sunduoze/my_heat/README.md

# my_heat
open source heat

## HW

ESP32-WROOM-32
JW5018B / EUP3458 /JW5026
KLJ-4020
WL2861K33-3-TR
CH224 NC
RT9193
TP6841S6-A
ME3116
MLT-7525
MAX6675ISA
K5-1672SN-01
LM6142
CH340E
SIQ-02FVS3	
OLED-12864-1.3-TOP
KLJ-4020	 buzzer
USB3.1C16PFSMT
XT30PW-M
