sunduoze/my_heat/enzo calc.md

# OpenHeat：开源智能加热台

初始电阻：25摄氏度 R_25 = 2.82 Ohm

软铜电导率 = 0.0175 Ohm*mm^2/m @20℃ 温度系数TCR：0.003951/℃

2.82R @25℃
2.82R*(1 + TCR*(285-25)℃) = 5.71R @285

铝基板热阻 2.0
