sunduoze/my_heat/[HW]my_heat/my_heat bom.xlsx

Bill of Materials Form/零件材料清单表
分发单位 |  |  |  |  |  | 408AL-00043GW
Finished coding/成品编码 |  |  |  |  | Project Name/项目名称 |  |  | Approved By/批准
REV/版本 |  | Description/更改描述 |  |  |  |  |  | Date/日期 |  |  | Raise by/发起人
001
002 |  | Modify U4 to JW5018B |  |  |  |  |  | 2022-04-10
Item/序号 | Level/级别 | Component type/零组件类型 | Model/物料编码=料号 | Name/零件名称 | Description/规格/描述 |  | Manufacturer/ 制造商 | Model/制造商P/N | Qty/用量 | Unit/单位 | Location /元件位置 | Property/环保属性 | Remarks/备注
0 |  |  | Part Number | Category | Description |  | Supplier 1 | Supplier Part Number 1 | Quantity |  | Designator |  |  | Footprint
 | 4 |  | 101CC-00003IA.01 | 贴片电容 | SMD,电容量100nF,额定电压50V,偏差±10%,材质X7R,0603 |  |  | 100nF,0603,50V | 8 |  | C1, C6, C10, C15, C17, C19, C21, C23 |  |  | C0603
 | 4 |  | 101CC-00453BW.01 | 贴片电容 | SMD,电容量10uF,额定电压10V,偏差±10%,材质X7R,0805 |  | YAGEO | CC0805KKX7R6BB106 | 2 |  | C2, C20 |  |  | C0805
 | 4 |  | 101CC-00005IA.01 | 贴片电容 | SMD,电容量1uF,额定电压50V,偏差±10%,材质X5R,0603 |  |  | 1uF,0603,50V | 4 |  | C3, C4, C9, C22 |  |  | C0603
 | 4 |  | 101CC-00006IA.01 | 贴片电容 | SMD,电容量10uF,额定电压25V,偏差±20%,材质X5R,0603 |  |  | 10uF,0603,25V | 2 |  | C5, C8 |  |  | C0603
 | 4 |  | 101CC-00004IA.01 | 贴片电容 | SMD,电容量100pF,额定电压50V,偏差±5%,材质NP0,0603 |  |  | 100pF,0603,50V | 3 |  | C7, C16, C18 |  |  | C0603
 | 4 |  | 101CC-00555BW.01 | 贴片电容 | SMD,电容量10uF,额定电压50V,偏差±10%,材质X7R,1210 |  | YAGEO | CC1210KKX7R9BB106 | 3 |  | C11, C12, C14 |  |  | C1210
 | 4 |  | 101CC-00490BW.01 | 贴片电容 | SMD,电容量220nF,额定电压50V,精度±10%,材质X7R,0603 |  | YAGEO | CC0603KRX7R9BB224 | 1 |  | C13 |  |  | C0603
 | 4 |  | 101CC-00390AV.01 | 贴片电容 | 安装方式SMD,电容量4.7uF,额定电压25V,偏差±10%,材质X5R,0603 |  | Murata | GRM188R61E475KE11D | 3 |  | C24, C25, C26 |  |  | C0603
 | 4 |  | 101RC-00049IA.01 | 贴片电阻 | SMD,阻值470R,精度±1%,0603,额定功率1/10W |  |  | 470R,0603,±1% | 3 |  | R1, R15, R46 |  |  | R0603
 | 4 |  | 101RC-01697BW.01, 101RC-01697BW.01, 101RC-01697BW.01, 101RC-01697BW.01, 101RC-01697BW.01, 101RC-01697BW.01, 101RC-01697BW.01, 101RC-01697BW.01, 101RC-01697BW.01, 101RC-00003IA.01, 101RC-01697BW.01, 101RC-01697BW.01, 101RC-01697BW.01, 101RC-01697BW.01, 101RC-00003IA.01 | 贴片电阻 | SMD,阻值10K,精度±0.1%,0603,额定功率1/10W, SMD,阻值10K,精度±0.1%,0603,额定功率1/10W, SMD,阻值10K,精度±0.1%,0603,额定功率1/10W, SMD,阻值10K,精度±0.1%,0603,额定功率1/10W, SMD,阻值10K,精度±0.1%,0603,额定功率1/10W, SMD,阻值10K,精度±0.1%,0603,额定功率1/10W, SMD,阻值10K,精度±0.1%,0603,额定功率1/10W, SMD,阻值10K,精度±0.1%,0603,额定功率1/10W, SMD,阻值10K,精度±0.1%,0603,额定功率1/10W, SMD,阻值10K,精度±1%,0603,额定功率1/10W, SMD,阻值10K,精度±0.1%,0603,额定功率1/10W, SMD,阻值10K,精度±0.1%,0603,额定功率1/10W, SMD,阻值10K,精度±0.1%,0603,额定功率1/10W, SMD,阻值10K,精度±0.1%,0603,额定功率1/10W, SMD,阻值10K,精度±1%,0603,额定功率1/10W |  | YAGEO, YAGEO, YAGEO, YAGEO, YAGEO, YAGEO, YAGEO, YAGEO, YAGEO, , YAGEO, YAGEO, YAGEO, YAGEO, | RT0603BRD0710KL, RT0603BRD0710KL, RT0603BRD0710KL, RT0603BRD0710KL, RT0603BRD0710KL, RT0603BRD0710KL, RT0603BRD0710KL, RT0603BRD0710KL, RT0603BRD0710KL, 10K,0603,±1%, RT0603BRD0710KL, RT0603BRD0710KL, RT0603BRD0710KL, RT0603BRD0710KL, 10K,0603,±1% | 15 |  | R2, R3, R4, R5, R6, R7, R8, R9, R12, R25, R27, R33, R34, R35, R43 |  |  | R0603
 | 4 |  | 101RC-00016IA.01 | 贴片电阻 | SMD,阻值10R,精度±1%,0603,额定功率1/10W |  |  | 10R,0603,±1% | 5 |  | R10, R14, R18, R23, R29 |  |  | R0603
 | 4 |  | 101RC-01944BW.01 | 贴片电阻 | SMD,阻值30K,精度±1%,0603,额定功率1/10W |  | YAGEO | RC0603FR-0730KL | 2 |  | R11, R22 |  |  | R0603
 | 4 |  | 101RC-00012IA.01 | 贴片电阻 | SMD,阻值0R,精度±1%,0603,额定功率1/10W |  |  | 0R,0603,±1% | 1 |  | R13 |  |  | R0603
 | 4 |  | 101RC-01892BW.01 | 贴片电阻 | SMD,阻值47K,精度±1%,0603,额定功率1/10W |  | YAGEO | RC0603FR-0747KL | 2 |  | R16, R45 |  |  | R0603
 | 4 |  | 101RC-00002IA.01 | 贴片电阻 | SMD,阻值1K,精度±1%,0603,额定功率1/10W |  |  | 1K,0603,±1% | 3 |  | R17, R21, R42 |  |  | R0603
 | 4 |  | 101RC-01223BS.01 | 贴片电阻 | 安装方式SMD,阻值0.01R,精度±1%,2512,额定功率1W,温漂系数±75 ppm/°C |  | Vishay | WSLT2512R0100FEA | 1 |  | R19 |  |  | R2512
 | 4 |  | 101RC-00040IA.01 | 贴片电阻 | SMD,阻值1M,精度±1%,0603,额定功率1/10W |  |  | 1M,0603,±1% | 2 |  | R20, R24 |  |  | R0603
 | 4 |  | 101RC-01784BW.01 | 贴片电阻 | 安装方式SMD,阻值1.5K,精度±1%,0603,额定功率1/10W |  | YAGEO | RC0603FR-071K5L | 1 |  | R26 |  |  | R0603
 | 4 |  | 101RC-00323BW.01 | 贴片电阻 | SMD,阻值100K,精度±0.1%,0603,额定功率1/10W |  | YAGEO | RT0603BRD07100KL | 4 |  | R28, R31, R38, R39 |  |  | R0603
 | 4 |  | 101RC-00378BW.01 | 贴片电阻 | SMD,阻值5.1K,精度±1%,0603,额定功率1/10W |  | YAGEO | RC0603FR-075K1L | 2 |  | R30, R32 |  |  | R0603
 | 4 |  | 101RC-00017IA.01 | 贴片电阻 | SMD,阻值100R,精度±1%,0603,额定功率1/10W |  |  | 100R,0603,±1% | 2 |  | R36, R37 |  |  | R0603
 | 4 |  | 101RC-00027BW.01 | 贴片电阻 | 安装方式SMD,阻值12K,精度±1%,0603,额定功率1/10W |  | YAGEO | RC0603FR-0712KL | 2 |  | R40, R41 |  |  | R0603
 | 4 |  | 101DG-00019AF.01 | 普通二极管 | SMD,SOD-523（0603）,额定电压80V,电流125mA |  | DIODES | 1N4148WT-7 | 1 |  | D1 |  |  | SOD-523
 | 4 |  | 101GP-00002DC.01 | PNP三极管 | SMD,封装形式SOT-23,耐压值40V,额定电流600mA,耗散功率300W |  | 长电科技 | MMBT4403 | 2 |  | Q1, Q2 |  |  | SOT-23-BCE
 | 4 |  | 101GN-00006BA.01 | NPN三极管 | SMD,封装形式SOT-23,耐压值40V,额定电流600mA,耗散功率225mW |  | ON | MMBT2222ALT1G | 4 |  | Q4, Q5, Q6, Q8 |  |  | SOT-23-BCE
 | 4 |  | 101MP-00024BA.01 | P型MOS管 | 安装方式SMD,封装方式SOT-23,额定电压-30V,耗散功率1.0W,Vgs-2.6V,额定电流-2.5A |  | ON | CPH3355-TL-W | 1 |  | Q7 |  |  | SOT-23-GDS
 | 4 |  | R0603 | 贴片电阻 | SMD，910K |  |  | 910k | 1 |  | R44 | D类 |  | R0603
 | 4 |  | MAX6675ISA+ |  | IC THERMOCOUP TO DGTL 8-SOIC |  | Digi-Key | MAX6675ISA+-ND (https://octopart-clicks.com/click/altium?sku=700-MAX6675ISA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) | 1 |  | U2 | D类 | V | SOIC8-1R27-5X4
 | 4 |  | 101IF-00039BK.01 | 运放IC | 安装方式SMD,SOIC-8,8PIN,运算放大器, |  | TI | LM6142 | 1 |  | U3 | D类 | M | SOIC8-1R27-5X4
 | 4 |  |  |  |  |  | JW | JW5018B | 1 |  | U4 | D类 | V | SOT-23-6_L2.9-W1.6-P0.95-LS2.8-BR
 | 4 |  |  |  |  |  | WILLSEMI(Will Semicon) | WL2861K33-3/TR | 1 |  | U5 | D类 | V | SOT-89-3_L4.5-W2.5-P1.50-LS4.2-BR
 | 4 |  |  |  |  |  |  | CH340E | 1 |  | U6 | D类 | V | MSOP-10_L3.0-W3.0-P0.50-LS5.0-BL
 | 4 |  |  |  | USB PD & Type-C & Fast Charge Power Consumer Controller |  |  | CH224K | 1 |  | U7 | D类 | V | ESSOP10
 | 4 |  |  |  |  |  | 精拓金 (https://list.szlcsc.com/brand/11735.html) | 918-418K2023S40001 | 1 |  | USB1 | D类 | V | Type-C-TOP
 | 4 |  |  | 拨轮滚轮旋转编码器开关 | SIQ-02FVS3 |  | MITSUMI(美上美) (https://list.szlcsc.com/brand/259.html) | 'SIQ-02FVS3 | 1 |  | SW1 | D类 | V
 | 4 |  |  |  |  |  |  | XT30PW-M | 1 |  | CN1 | D类 | NC | CONN-TH_XT30PW-M
 | 4 |  |  |  |  |  |  | SMBJ33CA | 1 |  | D2 | D类 | V | SMBJ-CA_MFG
 | 4 |  |  |  |  |  | KELIKING | KLJ-4020 | 1 |  | BUZZER1 | D类 | V | BUZ-SMD_L4.0-W4.0-P3.50-L
 | 4 |  |  |  |  |  |  | ESP32-WROOM-32 | 1 |  | U1 | D类 | M | WIFIM-SMD_ESP-32S
 | 4 |  | 101MN-00036AM.01 | N型MOS管 | SMD,封装方式TO263-3, |  | TI | CSD | 1 |  | Q3 | D类 | M | D2PAK-3-GDS
 | 4 |  |  |  |  |  | kinghelm(金航标) | KH-DC-007B-2.5G | 1 |  | DC1 | D类 | V
 | 4 |  |  |  |  |  |  | K5-1672SN-01 | 1 |  | SW2 | D类 | V
 | 4 |  |  |  | 显示屏 |  |  |  | 1 |  | OLED | D类 | NC | OLED-12864-1.3-TOP
 | 4 |  |  |  |  |  |  |  | 1 |  | OLED1 | D类 | M | OLED_0.69_8Pin
 | 4 |  | 101LP-00508BV.01 | 功率电感 | 安装方式SMD,电感值10uH,精度±20%,额定电流1.5A,屏蔽式,4.45x4.06x1.8mm |  | Wurth | 74437324100 SLO0420H100MTT | 1 |  | L1 | D类 | V | IND4R45X4R06X1-2 | Sunltech(韩国顺磁) (https://list.szlcsc.com/brand/11440.html)
 | 4 |  | 101DS-00045AF.01 | 肖特基二极管 | SMD,封装外壳SMC（DO-214AB）,额定电压40V,电流5A |  | DIODES | B540C-13-F | 1 |  | D5 | D类 | V | SMC
 | 4 |  | 101DS-00017AI.01 | 肖特基二极管 | SMD,封装外壳SOD-123-2,额定电压40V,电流1A |  | Fairchild | SS14FL | 2 |  | D3, D4 | D类 | V | SOD-123FL
