sunduoze/my_heat/[FW]my_heat/调试/esp32 adc.png

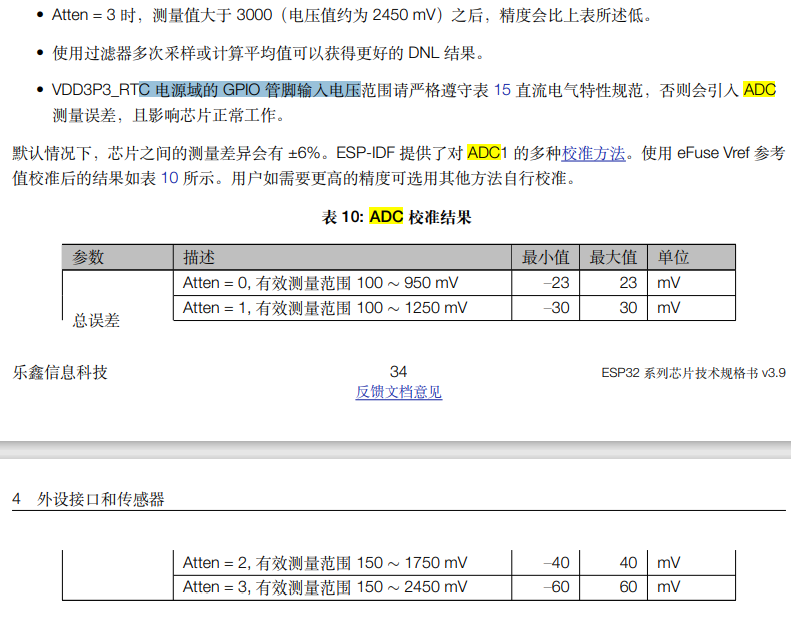
[FW]my_heat/调试/esp32 adc.png
