sunduoze/my_heat/[FW]my_heat/调试/kp8000-2.png

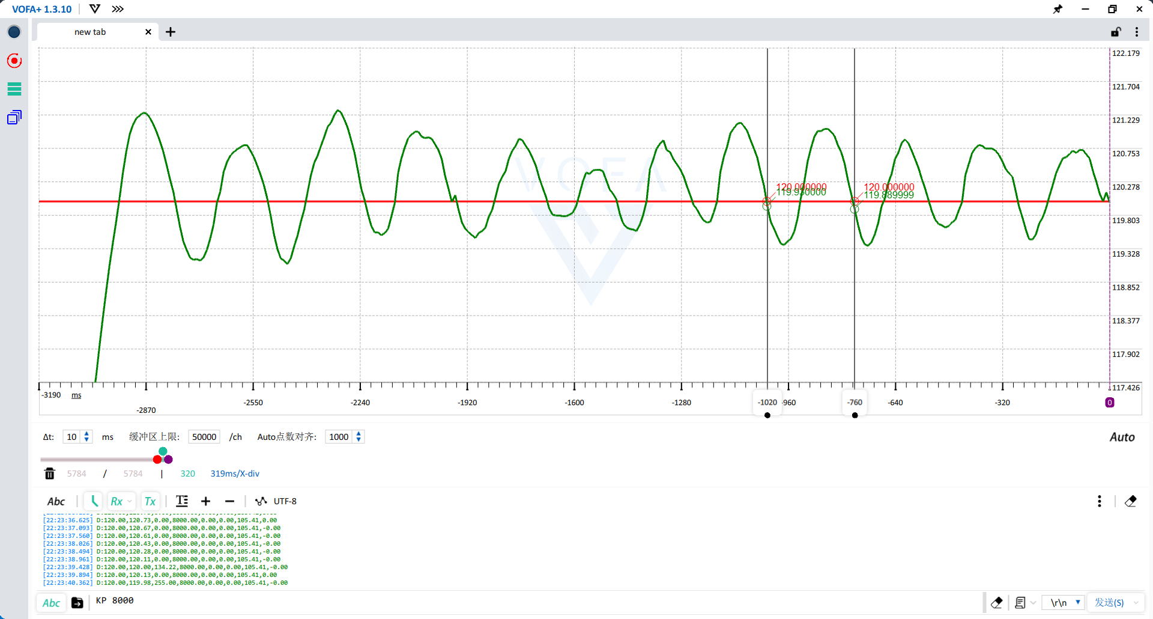
[FW]my_heat/调试/kp8000-2.png
