sunduoze/my_heat/[FW]my_heat/调试/Snipaste_2022-04-10_23-42-30.png

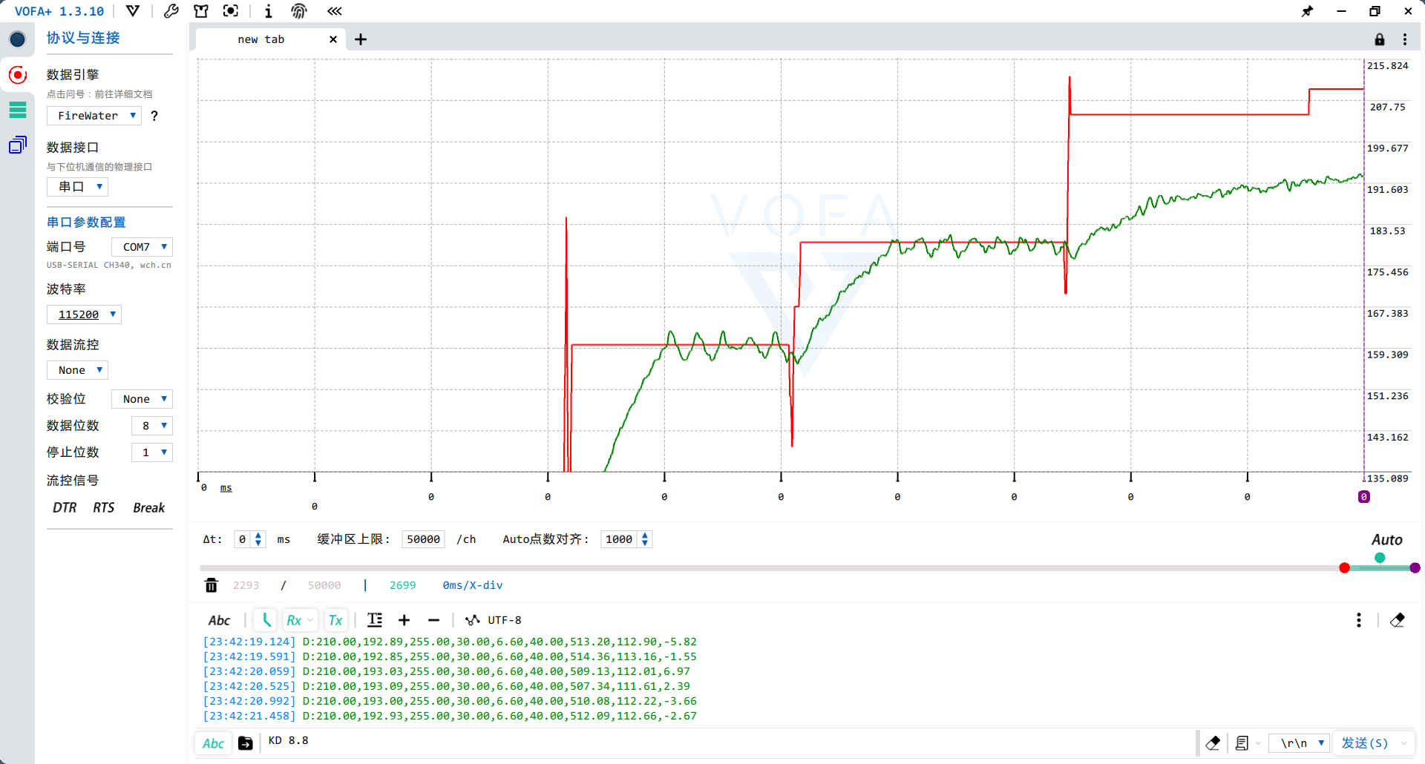
[FW]my_heat/调试/Snipaste_2022-04-10_23-42-30.png
