sunduoze/my_heat/(threads)

Thread 1 (2022-03-27):

错料

sunduoze, 2022-03-27:
1. DC1 下错料：KH-DC-007B-2.1G 应该修改为：KH-DC-007B-2.5G
2. TYPEC 错料：                               应该为：USB3.1C16PFSMT

sunduoze, 2022-03-27:
2.TYPEC 错料： 应该为：[精拓金](https://list.szlcsc.com/brand/11735.html) 918-418K2023S40001

sunduoze, 2022-03-27:
commit@20220327  fix this issue.

Closed 2022-03-27.

Thread 2 (2022-03-31):

npn & pnp 等相关电路设计错误

sunduoze, 2022-03-31:
pull-push circuit error
buzzer & pmos driver(need use npn).

sunduoze, 2022-03-31:
commit@20220331 fix pull-push circuit error, fix buzzer & pmos driver(need use npn).

Closed 2022-03-31.

Thread 3 (2022-04-01):

CH340E & CH224K USB存在抢占问题，导致CH340E无法使用

sunduoze, 2022-04-01:
CH340E & CH224K USB DP DN 均并联，导致存在抢占问题（USB PD正常，USB转串口无法使用）

sunduoze, 2022-04-01:
手动测量usb A口转C口 cable中A面DP DN 与B面DP DN不相连，拟采取插A面为USB转串口，插B面为PD受电端

Thread 4 (2022-04-07):

mosfet driver design failure

sunduoze, 2022-04-07:
first version----应该为上NPN，下PNP
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

sunduoze, 2022-04-07:
推挽电路输出电平电压会低于输入电平电压
![before](
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
https://user-images.githubusercontent.com/10105111/162122557-99a85a97-5852-46a7-8830-76632cdc7274.png)

sunduoze, 2022-04-07:
临时整改措施：
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
[mos-driver  push-pull circuit.zip](https://github.com/sunduoze/my_heat/files/8439746/mos-driver.push-pull.circuit.zip)

sunduoze, 2022-04-07:
临时整改措施：
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
仿真文件：
[mos-driver  push-pull circuit.zip](https://github.com/sunduoze/my_heat/files/8439746/mos-driver.push-pull.circuit.zip)

sunduoze, 2022-04-07:
commit@20220406 fix this issue
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

Closed 2022-04-07.
