sunduoze/my_heat/[HW]my_heat/my_heat.pdf

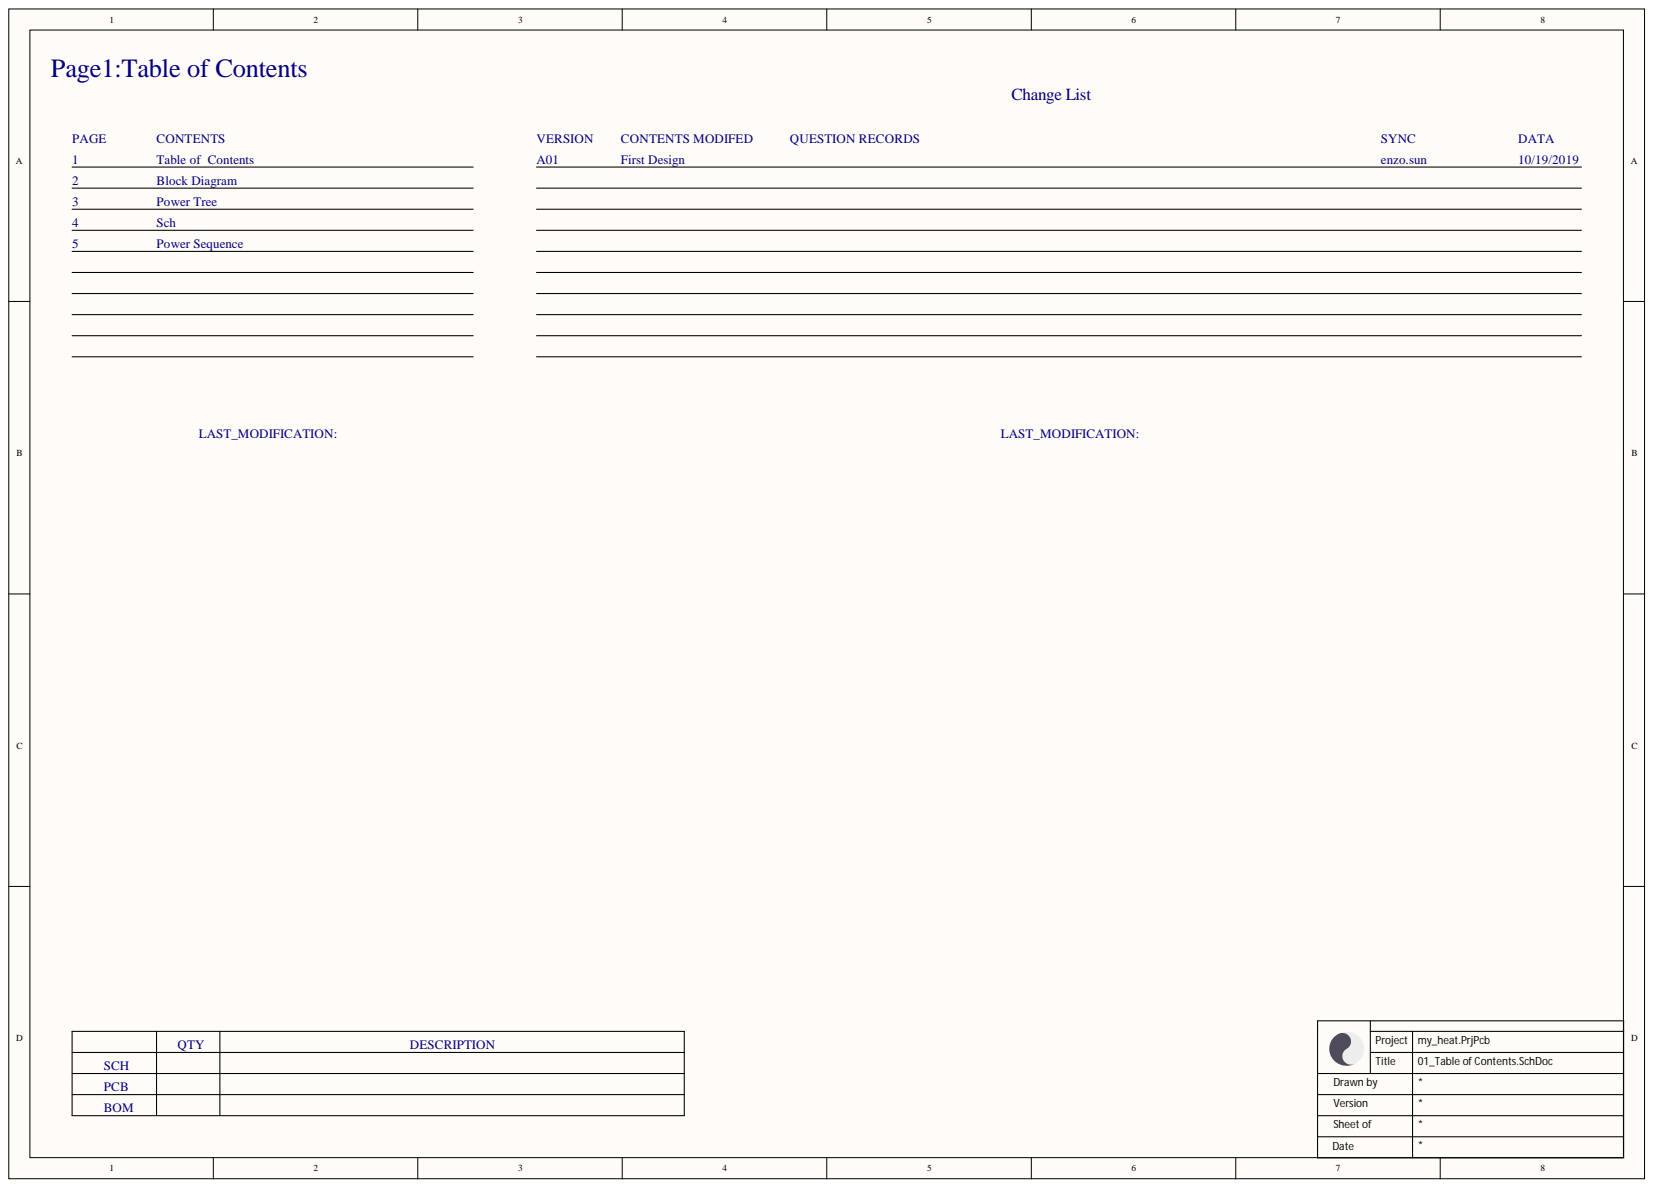
[picture p5: page 1]

Sheet of

Date | *

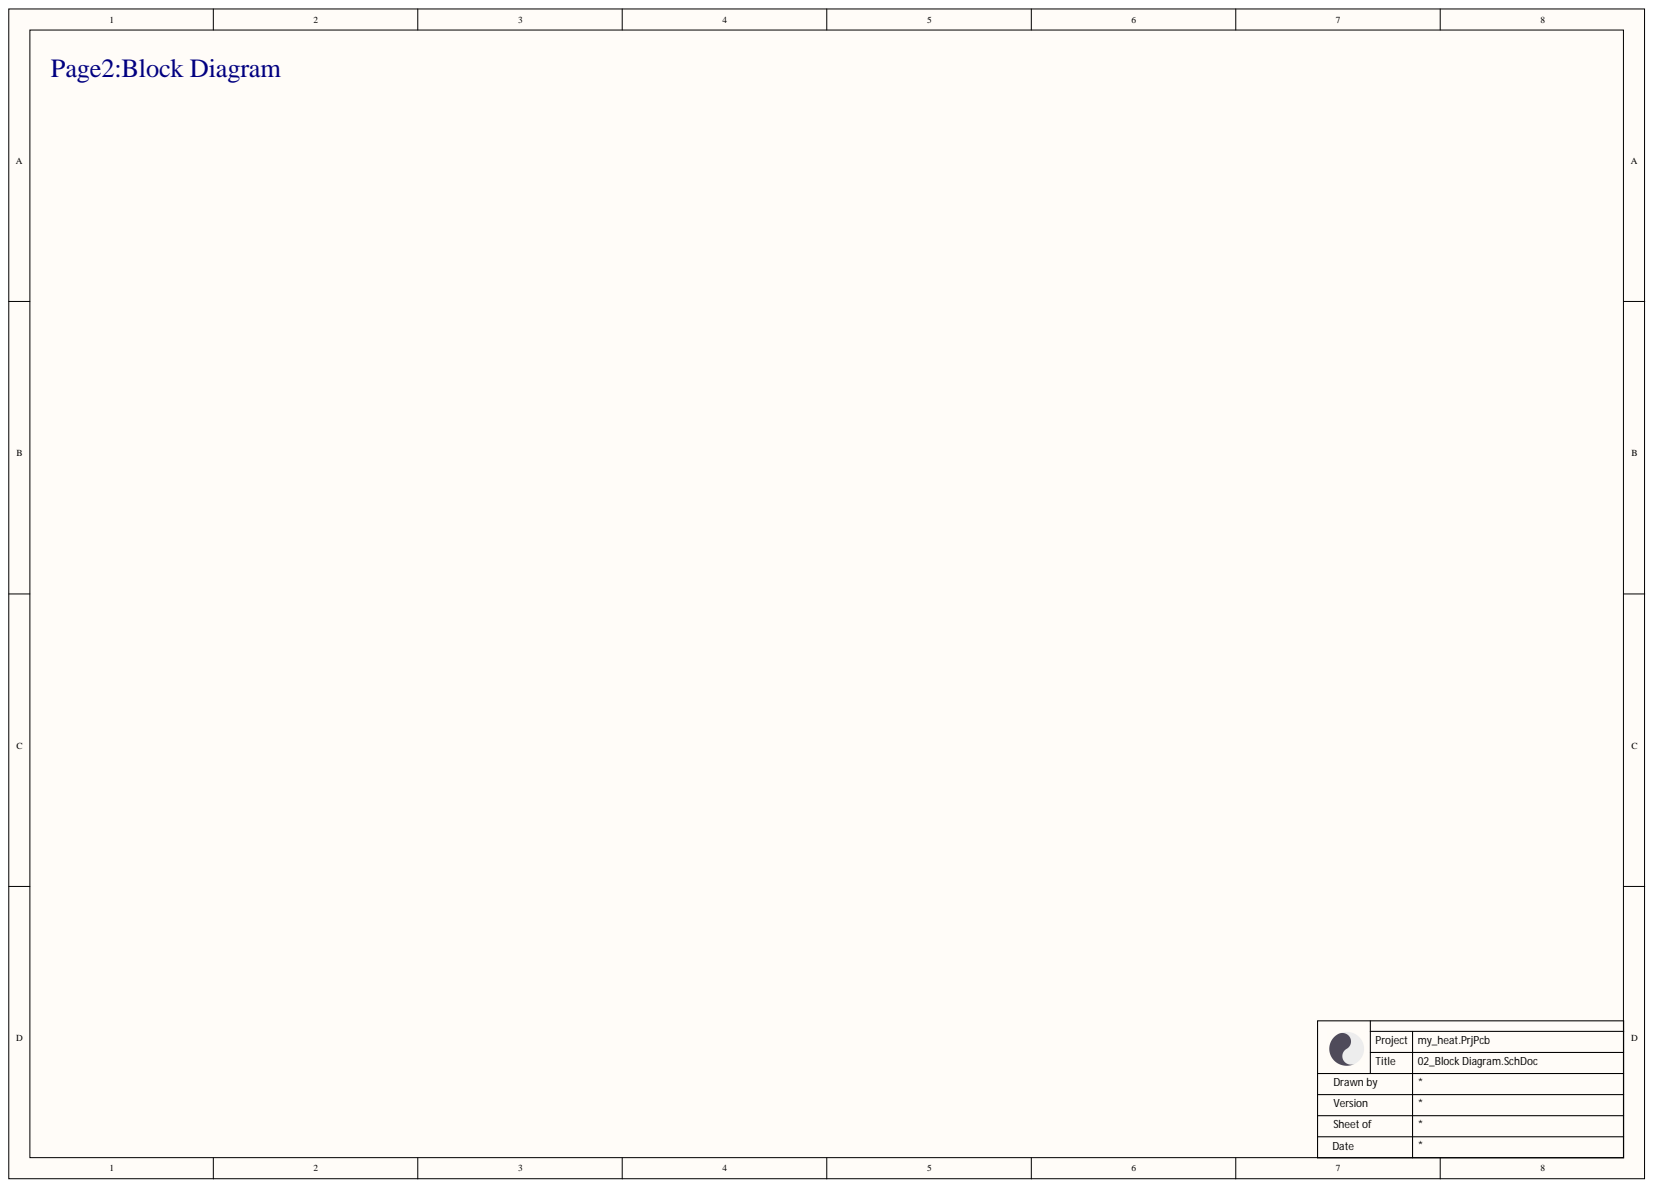
[picture p6: page 2]

Project | my_heat.PrjPcb

Title | 02_Block Diagram.SchDoc

Drawn by | | *

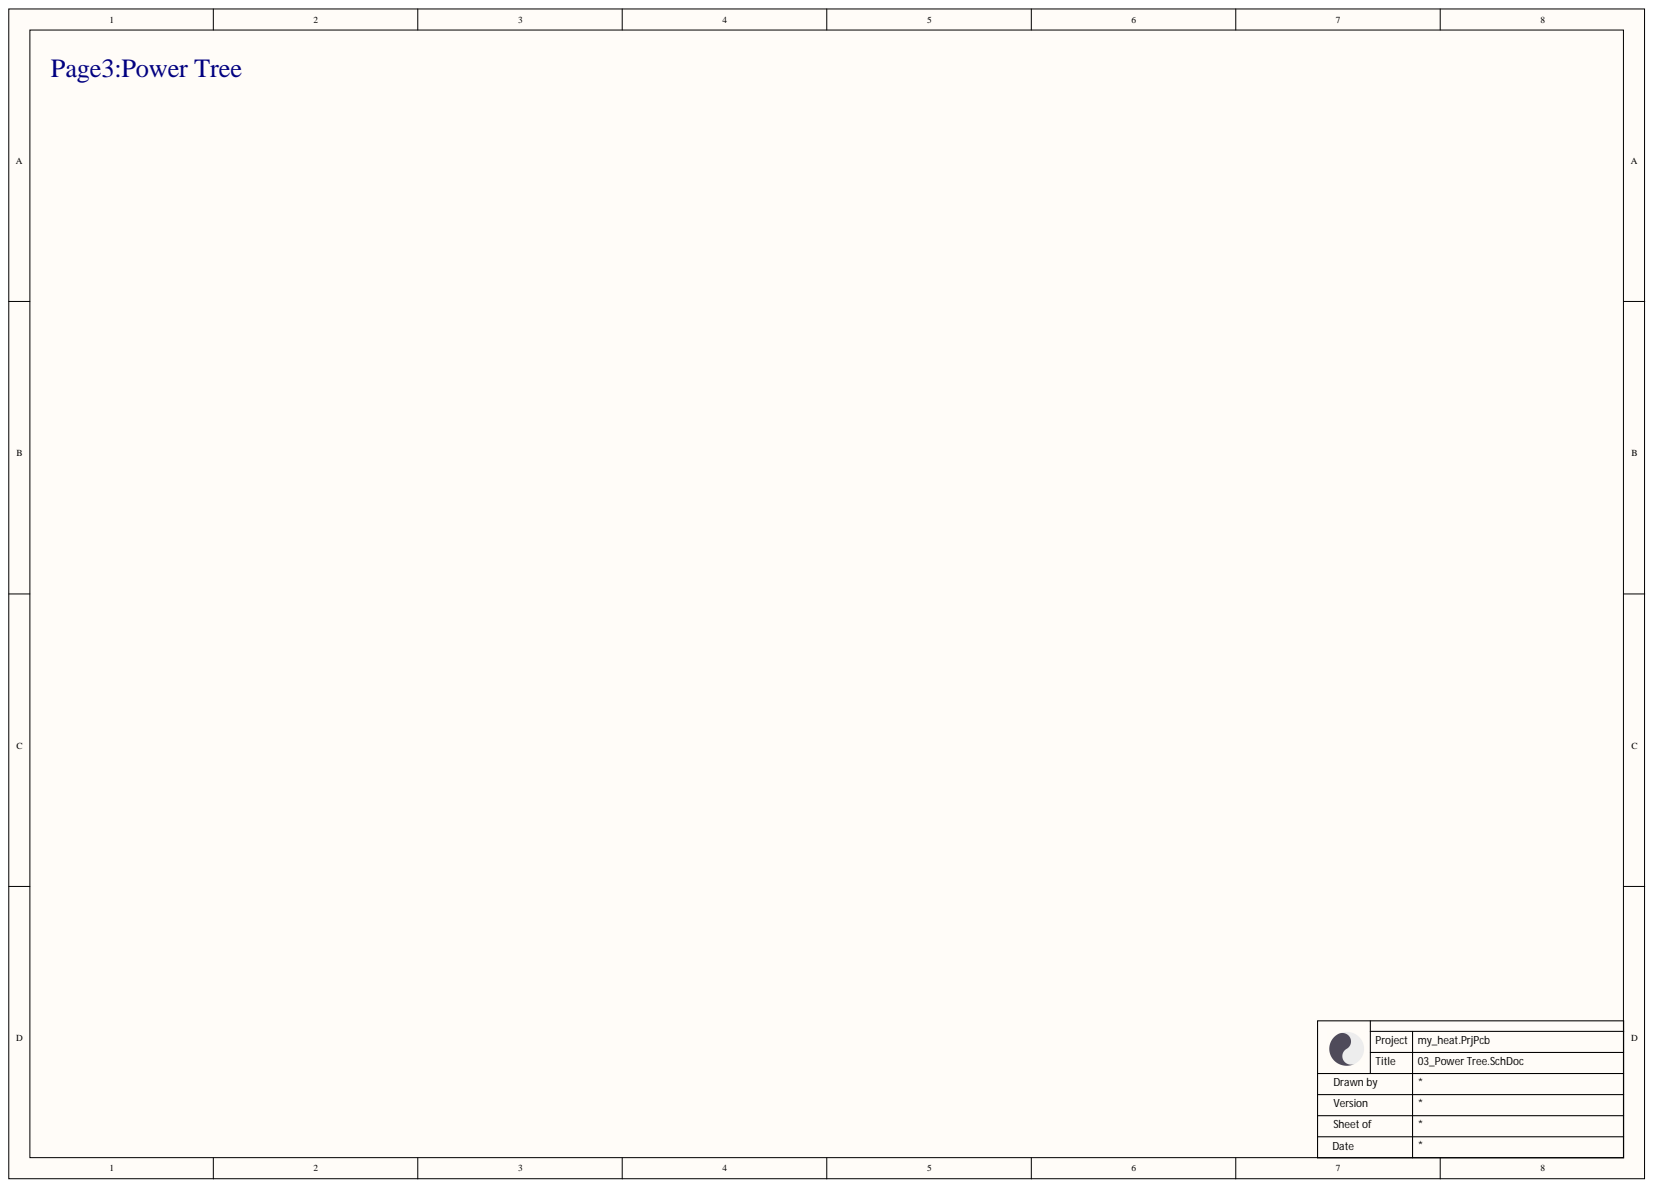
[picture p7: page 3]

Project | my_heat.PrjPcb

Title | 03_Power Tree.SchDoc

Drawn by | | *

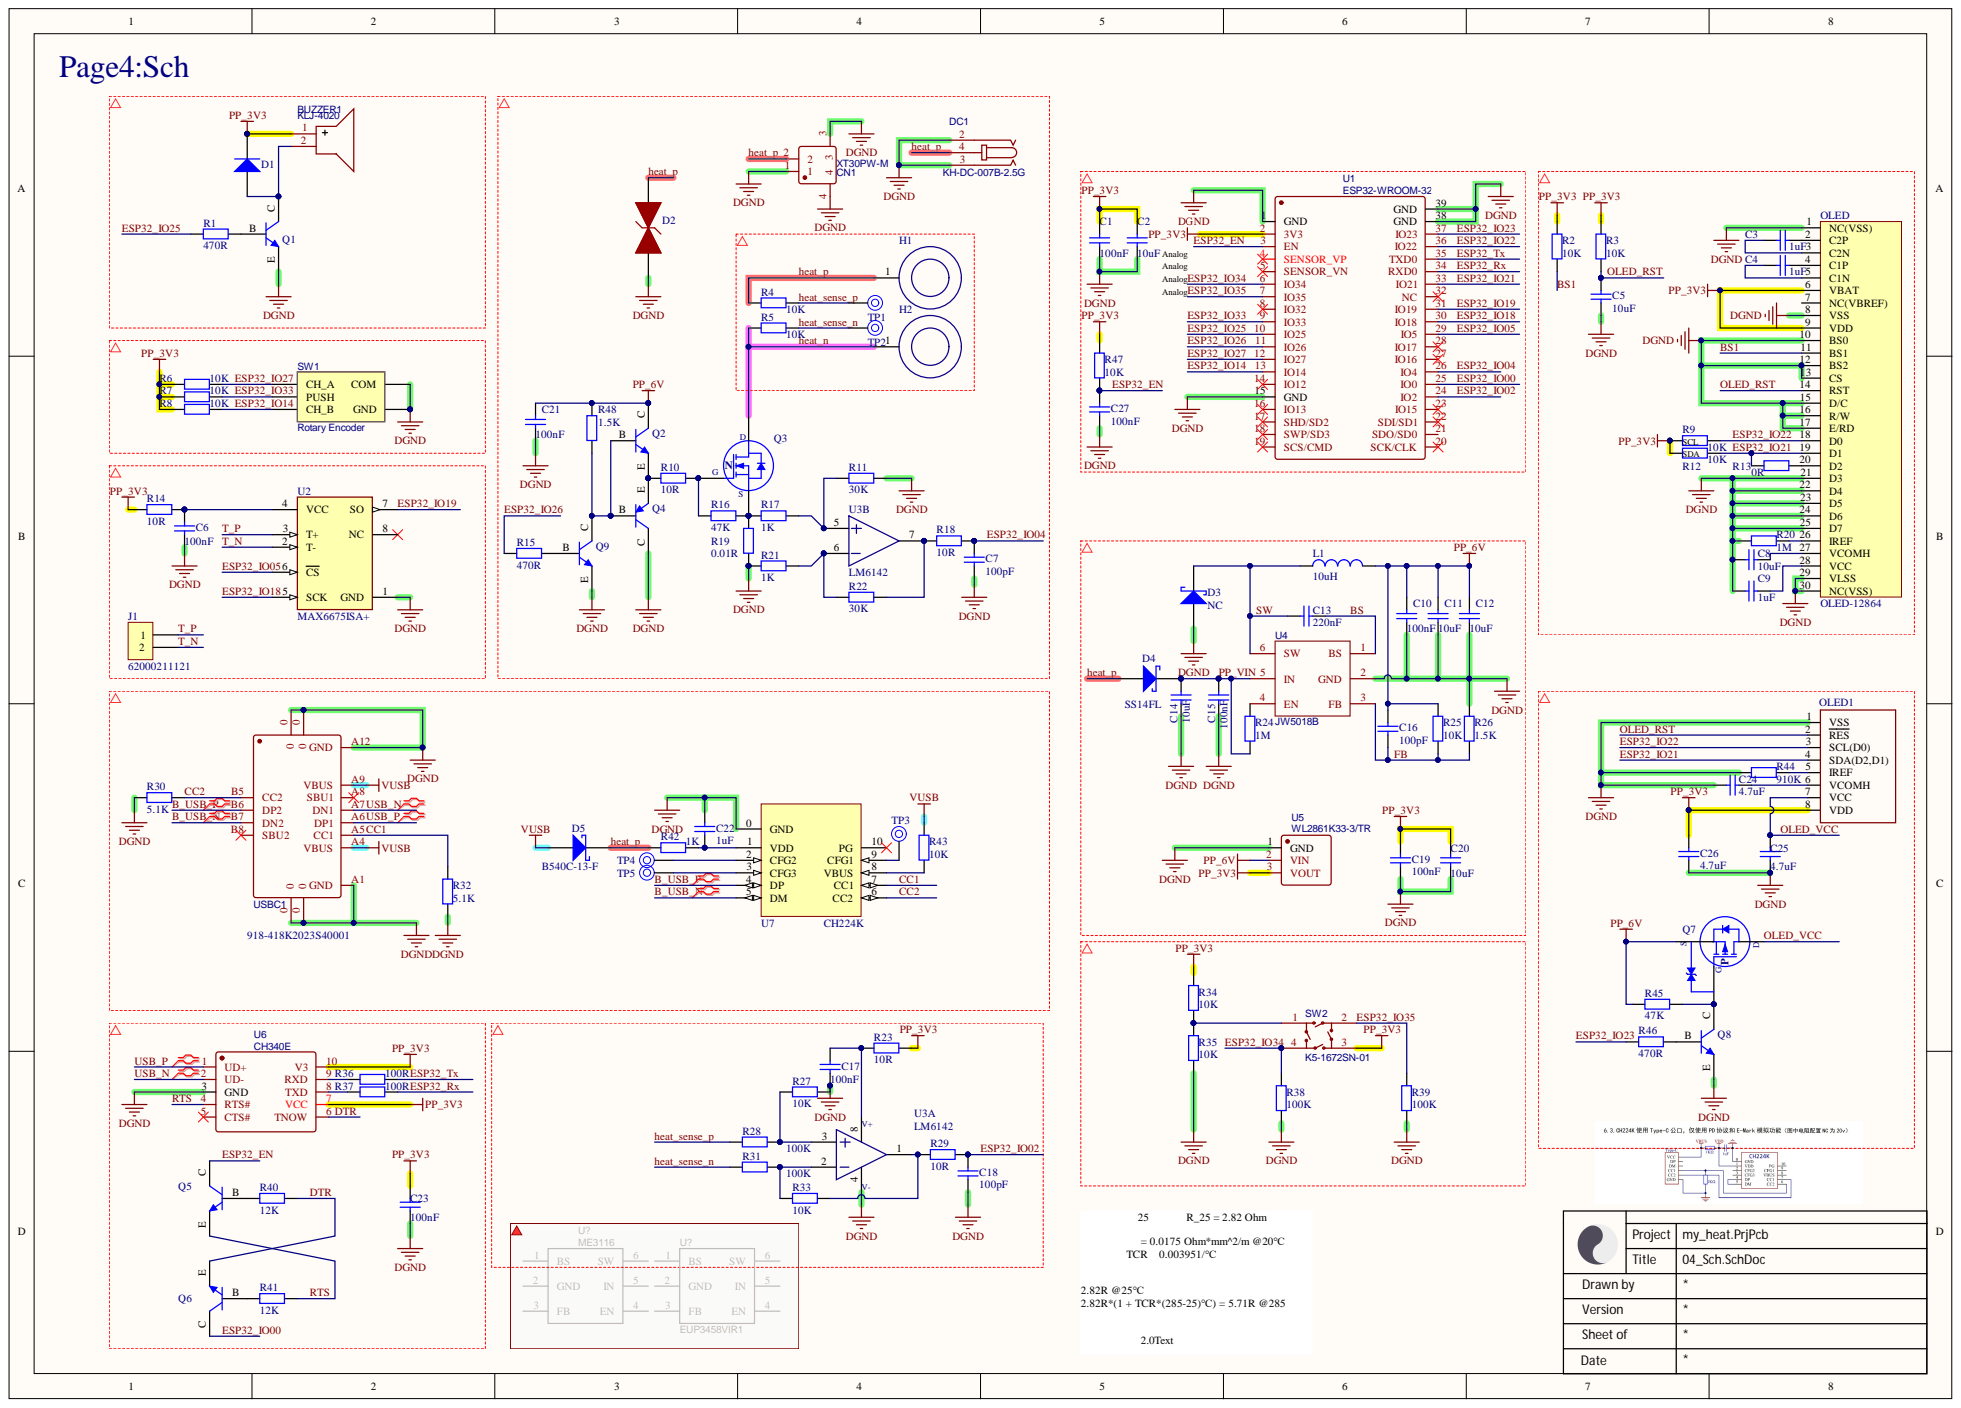
[picture p8: page 4]

PP_3V3 | | VCC 7

Title | 04_Sch.SchDoc

Drawn by | *

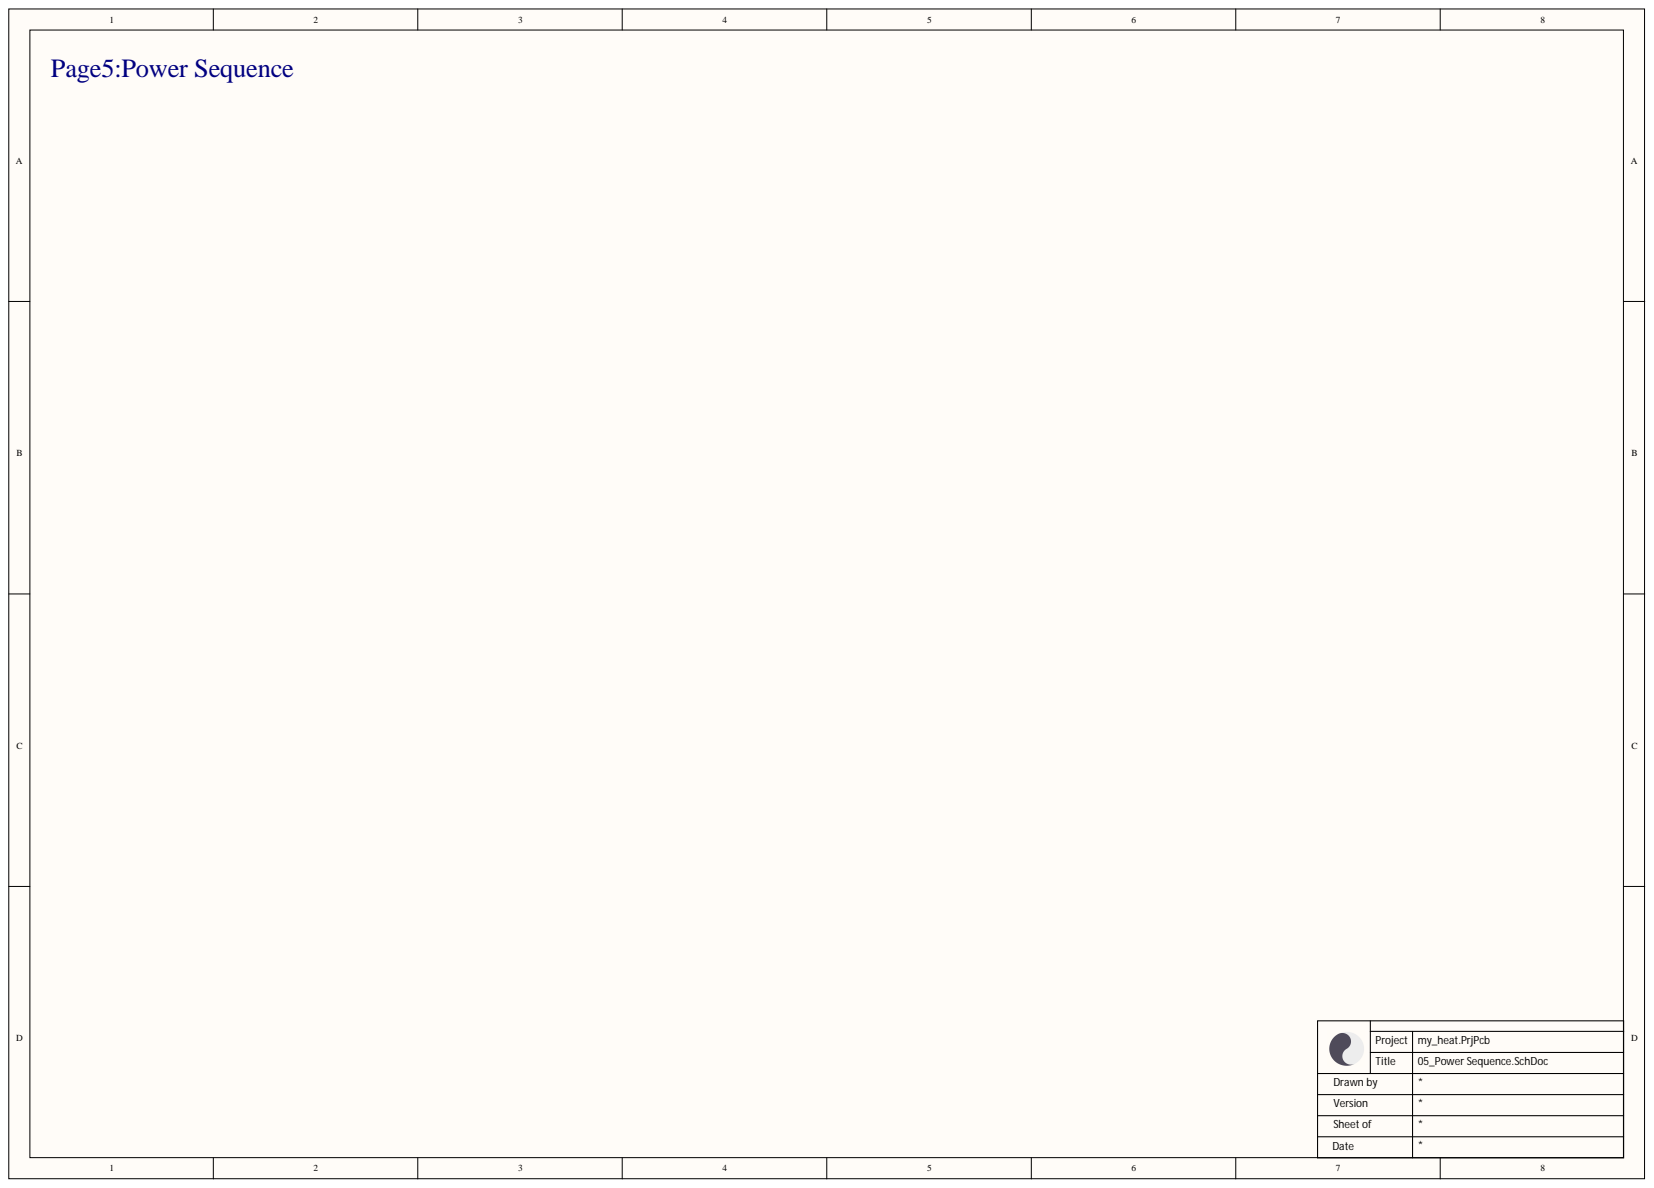
[picture p9: page 5]

Project | my_heat.PrjPcb

Title | 05_Power Sequence.SchDoc

Drawn by | | *

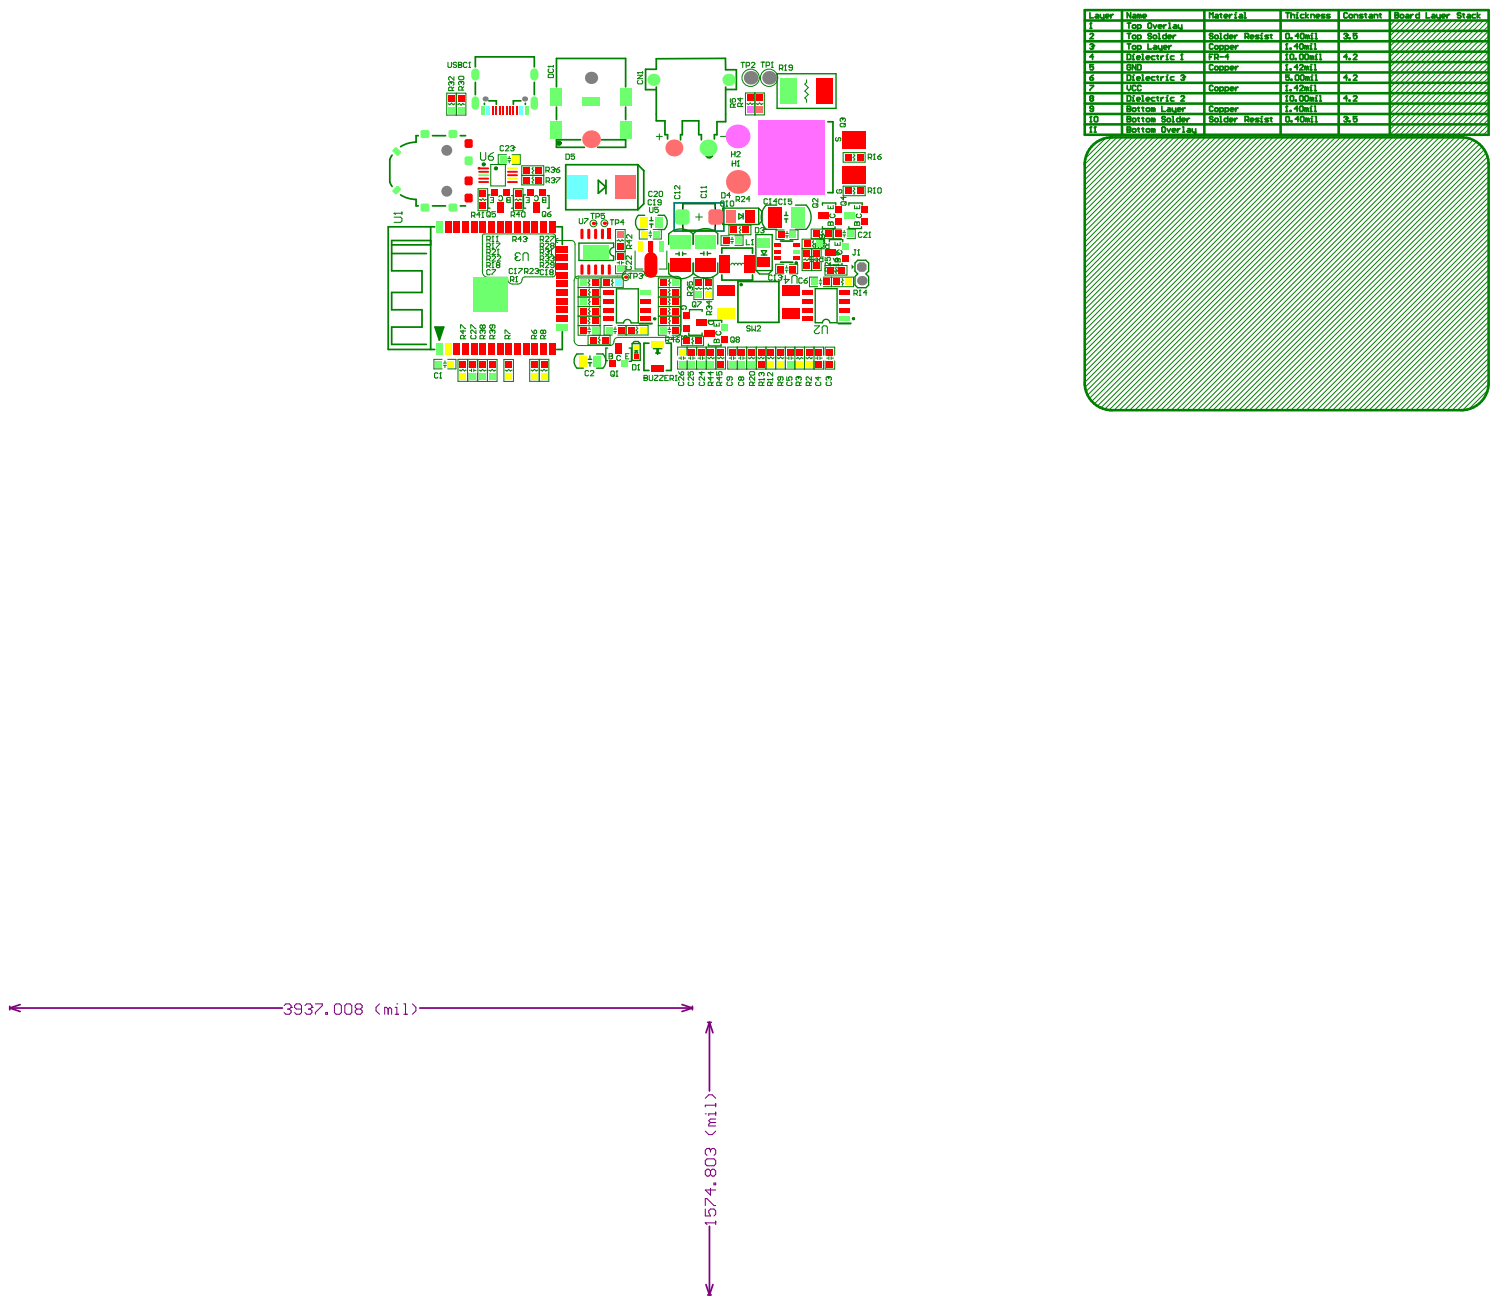
[picture p10: page 6]

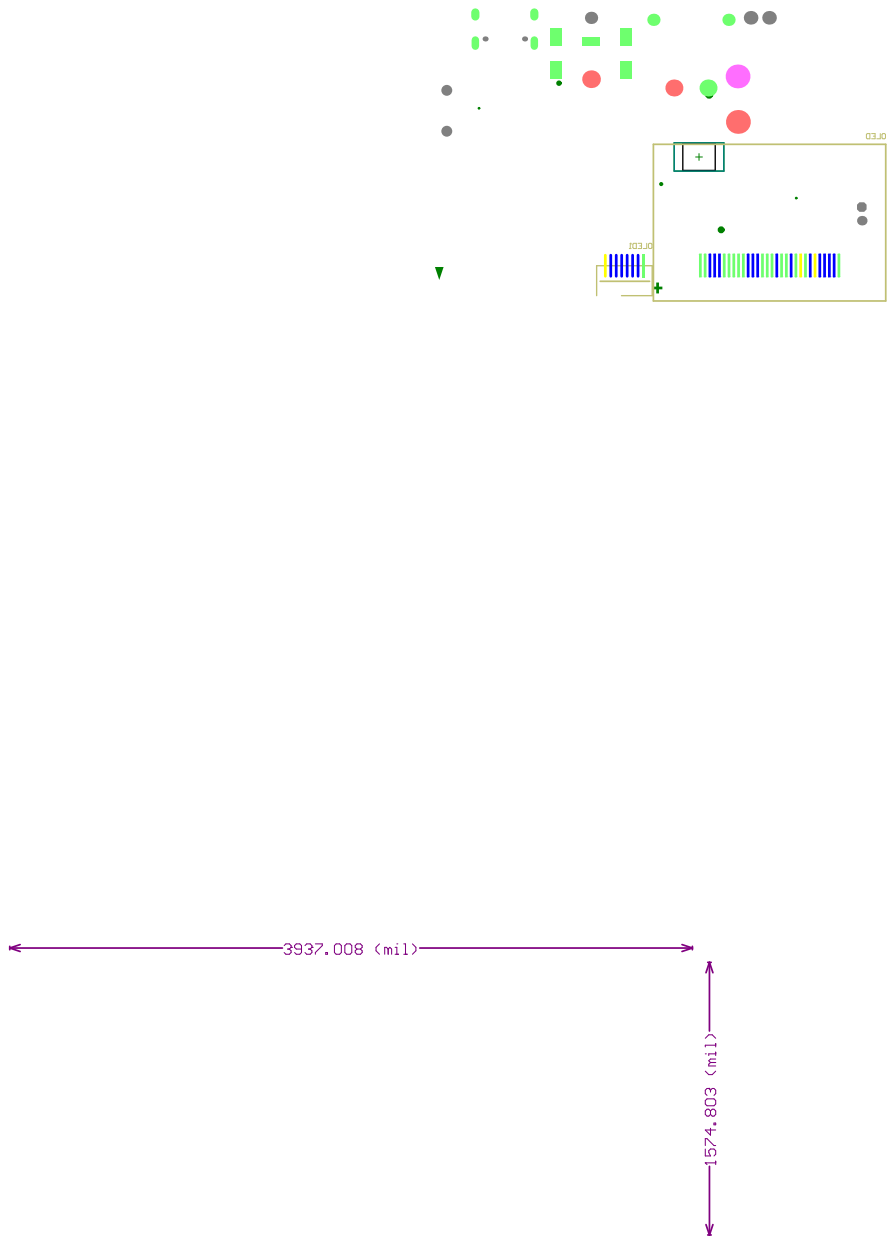
[picture p11: page 7]

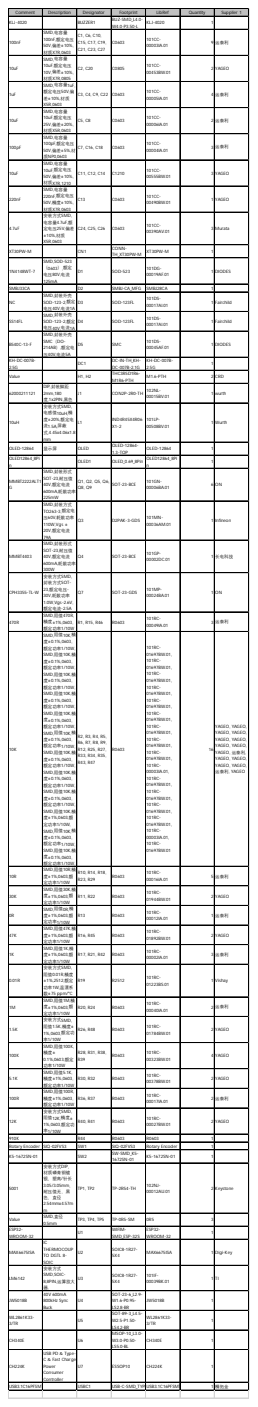
[picture p12: page 8]

Comment | Description | Designator | Footprint | LibRef | Quantity | Supplier 1
KLJ-4020 | | BUZZER1 | BUZ-SMD_L4.0-W4.0-P3.50-L | KLJ-4020 | | 1

100nF | SMD,电容量 100nF,额定电压 50V,偏差±10%, 材质X7R,0603 | C1, C6, C10, C15, C17, C19, C21, C23, C27 | C0603 | 101CC-00003IA.01 | | 9 运泰利

10uF | SMD,电容量 10uF,额定电压 10V,偏差±10%, 材质X7R,0805 | C2, C20 | C0805 | 101CC-00453BW.01 | | 2 YAGEO

1uF | SMD,电容量1uF, 额定电压50V,偏 差±10%,材质 X5R,0603 | C3, C4, C9, C22 | C0603 | 101CC-00005IA.01 | | 4 运泰利

10uF | SMD,电容量 10uF,额定电压 25V,偏差±20%, 材质X5R,0603 | C5, C8 | C0603 | 101CC-00006IA.01 | | 2 运泰利

100pF | SMD,电容量 100pF,额定电压 50V,偏差±5%,材 质NP0,0603 | C7, C16, C18 | C0603 | 101CC-00004IA.01 | | 3 运泰利

10uF | SMD,电容量 10uF,额定电压 50V,偏差±10%, 材质X7R,1210 | C11, C12, C14 | C1210 | 101CC-00555BW.01 | | 3 YAGEO

220nF | SMD,电容量 220nF,额定电压 50V,精度±10%, 材质X7R,0603 | C13 | C0603 | 101CC-00490BW.01 | | 1 YAGEO

4.7uF | 安装方式SMD, 电容量4.7uF,额 定电压25V,偏差 ±10%,材质 X5R,0603 | C24, C25, C26 | C0603 | 101CC-00390AV.01 | | 3 Murata

XT30PW-M | | CN1 | CONN-TH_XT30PW-M | XT30PW-M | | 1

1N4148WT-7 | SMD,SOD-523 （0603）,额定 电压80V,电流 125mA | D1 | SOD-523 | 101DG-00019AF.01 | | 1 DIODES

SMBJ33CA | | D2 | SMBJ-CA_MFG | SMBJ28CA | | 1
NC | SMD,封装外壳 SOD-123-2,额定 电压40V,电流1A | D3 | SOD-123FL | 101DS-00017AI.01 | | 1 Fairchild

SS14FL | SMD,封装外壳 SOD-123-2,额定 电压40V,电流1A | D4 | SOD-123FL | 101DS-00017AI.01 | | 1 Fairchild

B540C-13-F | SMD,封装外壳 SMC（DO-214AB）,额定电 压40V,电流5A | D5 | SMC | 101DS-00045AF.01 | | 1 DIODES

Value | | H1, H2 | THC3R5D1R6-M1R6-PTH | M1.6-PTH | | 2 CRD

62000211121 | DIP,封装脚距 2mm,180 度,1x2PIN,黑色 | J1 | CON2P-2R0-TH | 102NL-00015BV.01 | | 1 wurth

10uH | 安装方式SMD, 电感值10uH,精 度±20%,额定电 流1.5A,屏蔽 式,4.45x4.06x1.8 mm | L1 | IND4R45X4R06 X1-2 | 101LP-00508BV.01 | | 1 Wurth

OLED-12864 | 显示屏 | OLED | OLED-12864-1.3-TOP | OLED-12864 | | 1

OLED12864_8Pi n | | OLED1 | OLED_0.69_8Pin | OLED12864_8Pi n | | 1

MMBT2222ALT1 G | SMD,封装形式 SOT-23,耐压值 40V,额定电流 600mA,耗散功率 225mW | Q1, Q2, Q5, Q6, Q8, Q9 | SOT-23-BCE | 101GN-00006BA.01 | | 6 ON

SMD,封装方式 TO263-3,额定电 压60V,耗散功率 110W,Vgs ± 20V,额定电流 79A | Q3 | D2PAK-3-GDS | 101MN-00036AM.01 | | 1 Infineon

MMBT4403 | SMD,封装形式 SOT-23,耐压值 40V,额定电流 600mA,耗散功率 300W | Q4 | SOT-23-BCE | 101GP-00002DC.01 | | 1 长电科技

CPH3355-TL-W | 安装方式SMD, 封装方式SOT-23,额定电压-30V,耗散功率 1.0W,Vgs-2.6V, 额定电流-2.5A | Q7 | SOT-23-GDS | 101MP-00024BA.01 | | 1 ON

470R | SMD,阻值470R, 精度±1%,0603, 额定功率1/10W | R1, R15, R46 | R0603 | 101RC-00049IA.01 | | 3 运泰利

10K | SMD,阻值10K,精 度±0.1%,0603, 额定功率1/10W, SMD,阻值10K,精 度±0.1%,0603, 额定功率1/10W, SMD,阻值10K,精 度±0.1%,0603, 额定功率1/10W, SMD,阻值10K,精 度±0.1%,0603, 额定功率1/10W, SMD,阻值10K,精 度±0.1%,0603, 额定功率1/10W, SMD,阻值10K,精 度±0.1%,0603, 额定功率1/10W, SMD,阻值10K,精 度±0.1%,0603, 额定功率1/10W, SMD,阻值10K,精 度±0.1%,0603, 额定功率1/10W, SMD,阻值10K,精 度±0.1%,0603, 额定功率1/10W, SMD,阻值10K,精 度±1%,0603,额 定功率1/10W, SMD,阻值10K,精 度±0.1%,0603, 额定功率1/10W, SMD,阻值10K,精 度±0.1%,0603, 额定功率1/10W, | R2, R3, R4, R5, R6, R7, R8, R9, R12, R25, R27, R33, R34, R35, R43, R47 | R0603 | 101RC-01697BW.01, 101RC-01697BW.01, 101RC-01697BW.01, 101RC-01697BW.01, 101RC-01697BW.01, 101RC-01697BW.01, 101RC-01697BW.01, 101RC-01697BW.01, 101RC-01697BW.01, 101RC-00003IA.01, 101RC-01697BW.01, 101RC-01697BW.01, 101RC-01697BW.01, 101RC-01697BW.01, 101RC-00003IA.01, 101RC-01697BW.01 | | YAGEO, YAGEO, YAGEO, YAGEO, YAGEO, YAGEO, 16 YAGEO, YAGEO, YAGEO, 运泰利, YAGEO, YAGEO, YAGEO, YAGEO, 运泰利, YAGEO

10R | SMD,阻值10R,精 度±1%,0603,额 定功率1/10W | R10, R14, R18, R23, R29 | R0603 | 101RC-00016IA.01 | | 5 运泰利

30K | SMD,阻值30K,精 度±1%,0603,额 定功率1/10W | R11, R22 | R0603 | 101RC-01944BW.01 | | 2 YAGEO

0R | SMD,阻值0R,精 度±1%,0603,额 定功率1/10W | R13 | R0603 | 101RC-00012IA.01 | | 1 运泰利

47K | SMD,阻值47K,精 度±1%,0603,额 定功率1/10W | R16, R45 | R0603 | 101RC-01892BW.01 | | 2 YAGEO

1K | SMD,阻值1K,精 度±1%,0603,额 定功率1/10W | R17, R21, R42 | R0603 | 101RC-00002IA.01 | | 3 运泰利

0.01R | 安装方式SMD, 阻值0.01R,精度 ±1%,2512,额定 功率1W,温漂系 数±75 ppm/°C | R19 | R2512 | 101RC-01223BS.01 | | 1 Vishay

1M | SMD,阻值1M,精 度±1%,0603,额 定功率1/10W | R20, R24 | R0603 | 101RC-00040IA.01 | | 2 运泰利

1.5K | 安装方式SMD, 阻值1.5K,精度± 1%,0603,额定功 率1/10W | R26, R48 | R0603 | 101RC-01784BW.01 | | 2 YAGEO

100K | SMD,阻值100K, 精度± 0.1%,0603,额定 功率1/10W | R28, R31, R38, R39 | R0603 | 101RC-00323BW.01 | | 4 YAGEO

5.1K | SMD,阻值5.1K, 精度±1%,0603, 额定功率1/10W | R30, R32 | R0603 | 101RC-00378BW.01 | | 2 YAGEO

100R | SMD,阻值100R, 精度±1%,0603, 额定功率1/10W | R36, R37 | R0603 | 101RC-00017IA.01 | | 2 运泰利

12K | 安装方式SMD, 阻值12K,精度± 1%,0603,额定功 率1/10W | R40, R41 | R0603 | 101RC-00027BW.01 | | 2 YAGEO

910K | | R44 | R0603 | R0603 | | 1
Rotary Encoder | SIQ-02FVS3 | SW1 | SIQ-02FVS3 | Rotary Encoder | | 1
K5-1672SN-01 | | SW2 | SW-SMD_K5-1672SN-01 | K5-1672SN-01 | | 1

5001 | 安装方式DIP， 材质磷青铜镀 银，塑高/针长 3.05/3.05mm， 耐压值无，黑 色，直径 2.54mmx4.57m m | TP1, TP2 | TP-2R54-TH | 102NJ-00012AU.01 | | 2 Keystone

Value | SMD,直径 0.5mm | TP3, TP4, TP5 | TP-0R5-SM | 0R5 | | 3

ESP32-WROOM-32 | | U1 | WIFIM-SMD_ESP-32S | ESP32-WROOM-32 | | 1

MAX6675ISA | IC THERMOCOUP TO DGTL 8-SOIC | U2 | SOIC8-1R27-5X4 | MAX6675ISA | | 1 Digi-Key

LM6142 | 安装方式 SMD,SOIC-8,8PIN,运算放大 器, | U3 | SOIC8-1R27-5X4 | 101IF-00039BK.01 | | 1 TI

JW5018B | 40V 600mA 800kHz Sync Buck | U4 | SOT-23-6_L2.9-W1.6-P0.95-LS2.8-BR | JW5018B | | 1

WL2861K33-3/TR | | U5 | SOT-89-3_L4.5-W2.5-P1.50-LS4.2-BR | WL2861K33-3/TR | | 1

CH340E | | U6 | MSOP-10_L3.0-W3.0-P0.50-LS5.0-BL | CH340E | | 1

CH224K | USB PD & Type-C & Fast Charge Power Consumer Controller | U7 | ESSOP10 | CH224K | | 1

USB3.1C16PFSMT | | USBC1 | USB-C-SMD_TYPEUSB 3.1C16P FSMT | | | 1 精拓金
