sunduoze/my_heat/(list of files, drawings)

Other design files:
[HW]my_heat/01_Table of Contents.SchDoc
[HW]my_heat/02_Block Diagram.SchDoc
[HW]my_heat/03_Power Tree.SchDoc
[HW]my_heat/04_Sch.SchDoc
[HW]my_heat/05_Power Sequence.SchDoc
[HW]my_heat/HotBed-24V.PcbDoc
[HW]my_heat/my_heat.PrjPcb
[HW]my_heat/my_heat.SCHLIB
