sunduoze/my_heat/(commit log)

2022-03-27 commit@20220327 first commit.
    [01_Table of Contents.SchDoc, 02_Block Diagram.SchDoc, 03_Power Tree.SchDoc, 04_Sch.SchDoc, 05_Power Sequence.SchDoc, my_heat bom.xlsx, my_heat.PrjPcb]
2022-03-27 commit@20220327 HW_A01.
    [my_heat bom.xlsx]
2022-03-27 commit@20220327 fix 错料 issue.
    [04_Sch.SchDoc, my_heat bom.xlsx]
2022-03-31 commit@20220331 fix pull-push circuit error, fix buzzer & pmos driver(need use npn).
    [04_Sch.SchDoc]
2022-04-01 commit@20220401 fix usb设计错误，将 CH340E & CH224K 公用USB，现利用正反插实现不同功能，插A面为USB转串口，插B面为PD受电端 待验证
    [04_Sch.SchDoc]
2022-04-06 commit@20220406 + firmware.
    [04_Sch.SchDoc]
2022-04-06 commit@20220406 fix mos deiver pull-push issue,
    [04_Sch.SchDoc, my_heat.PrjPcb]
2022-04-07 commit@20220407 match code with circuit for "PMOS" driver.
2022-04-26 commit@20220426 update code.
    [04_Sch.SchDoc, my_heat bom.xlsx, my_heat.PrjPcb, my_heat.SCHLIB]
2025-05-26 add heater bed
    [HotBed-24V.PcbDoc]
